ianm8/uDSR/src/README.md

## Prerequisites
This is an Arduino project for the Pi Pico 2. You will need the Pico Arduino core by Earle Philhower available here:

https://github.com/earlephilhower/arduino-pico

## Libraries
 * Install the Tiny4kOLED library: https://github.com/datacute/Tiny4kOLED
 
## Build
 * Seeed XIAO RP2350
 * CPU Speed: 250Mhz
 * Optimize: -O3
 * USB Stack: No USB
 * Flash Size: 2MB (no FS)

## Some history
 * 0.1.250 start with uDST, uPDCR, and iqSDR40
 * 0.2.250 firmware update from menu
 * 0.3.250 smeter fixes
 * 0.4.250 set smeter by mode
 * 0.5.250 dithered waterfall
 * 0.6.250 waterfall speed
 * 0.7.250 improved noise blanker
 * 1.0.250 release
 * 1.1.250 limiter (audio blanker)
