ianm8/uDSR/PCB/README.md

# PCB Top View

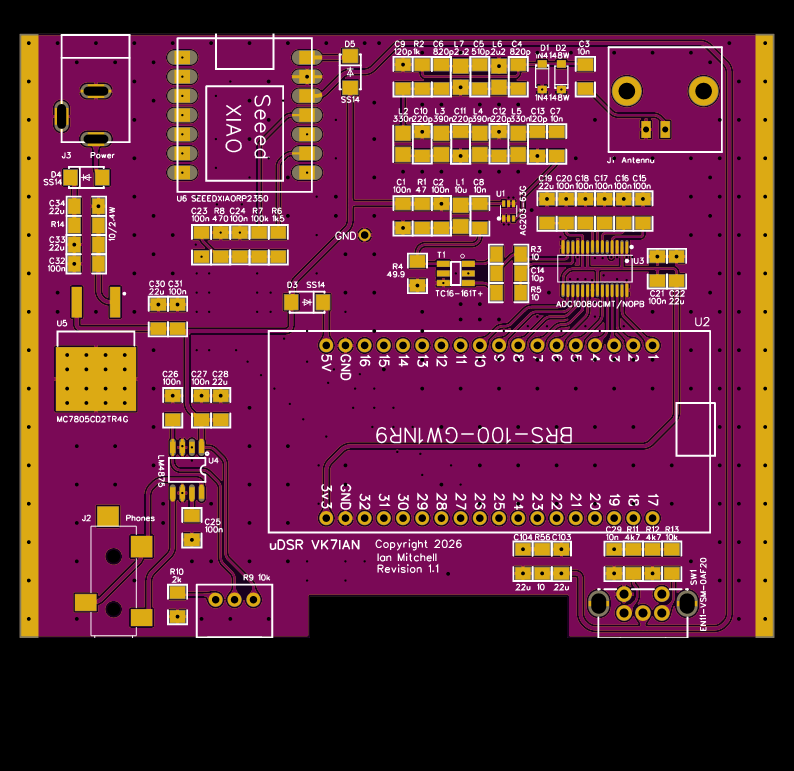
[picture p6: PCB/uDSR-Top-View_2026-10-17.png]
uDSR PCB Top


# PCB Bottom View

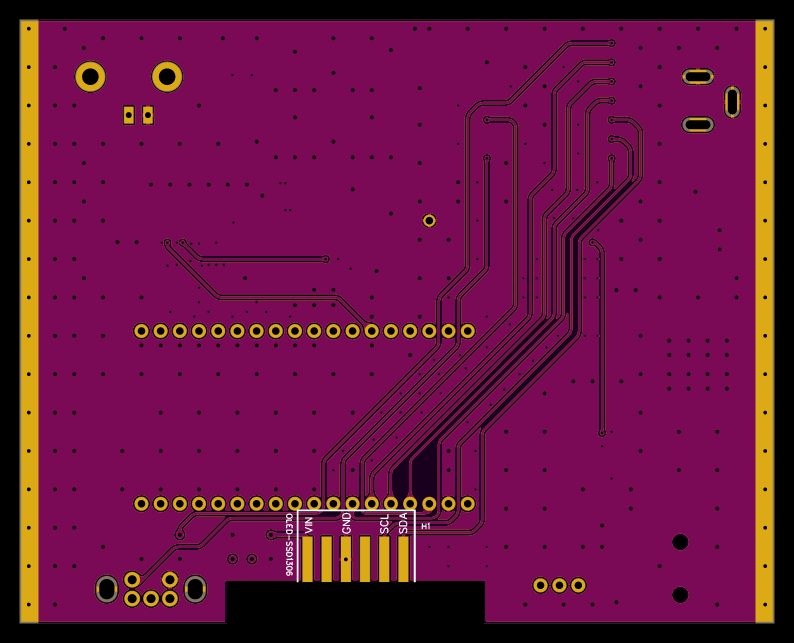
[picture p7: PCB/uDSR-Bottom-View_2026-10-17.png]
uDSR PCB Bottom
