ianm8/uDSR/docs/uDSR_CIC_response.png

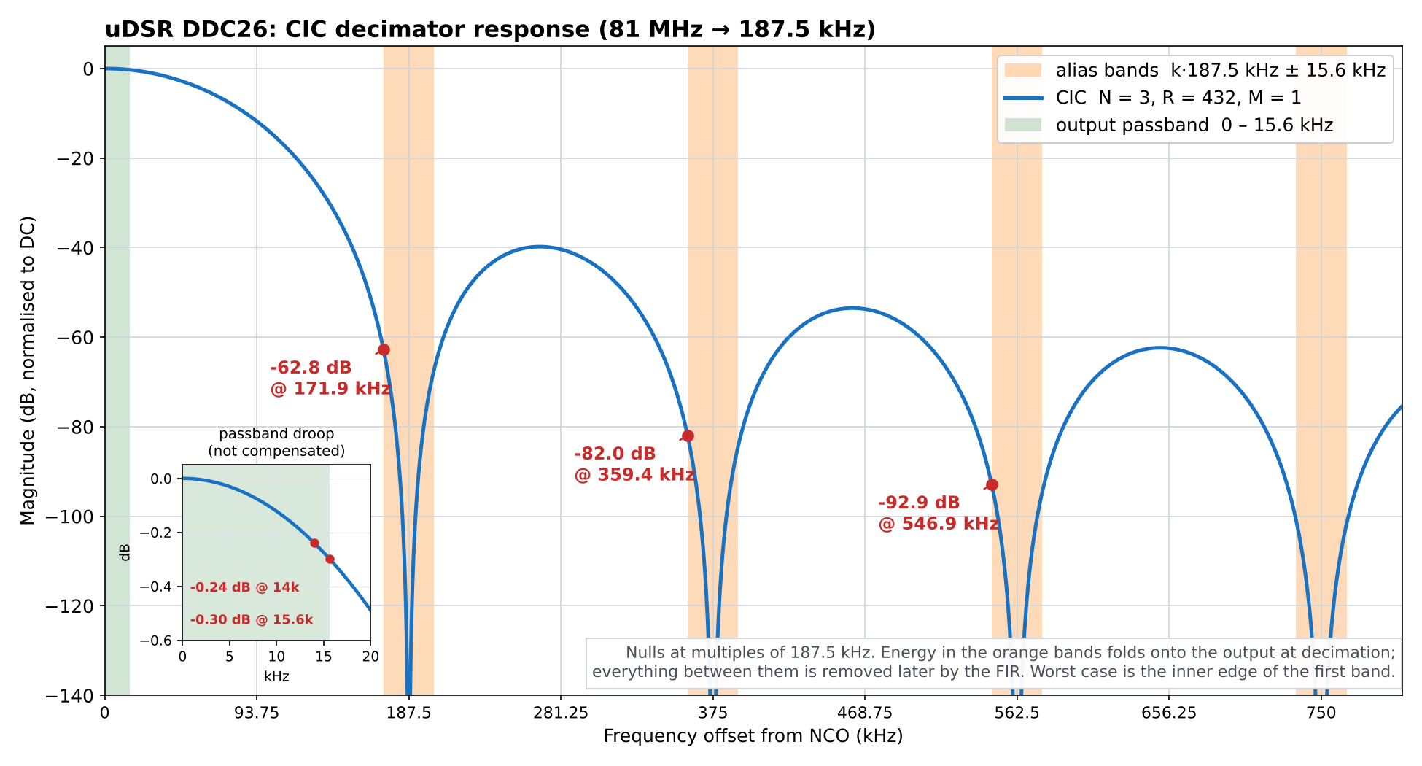
docs/uDSR_CIC_response.png
