ianm8/uDSR/docs/uDSR_FIR_response.png

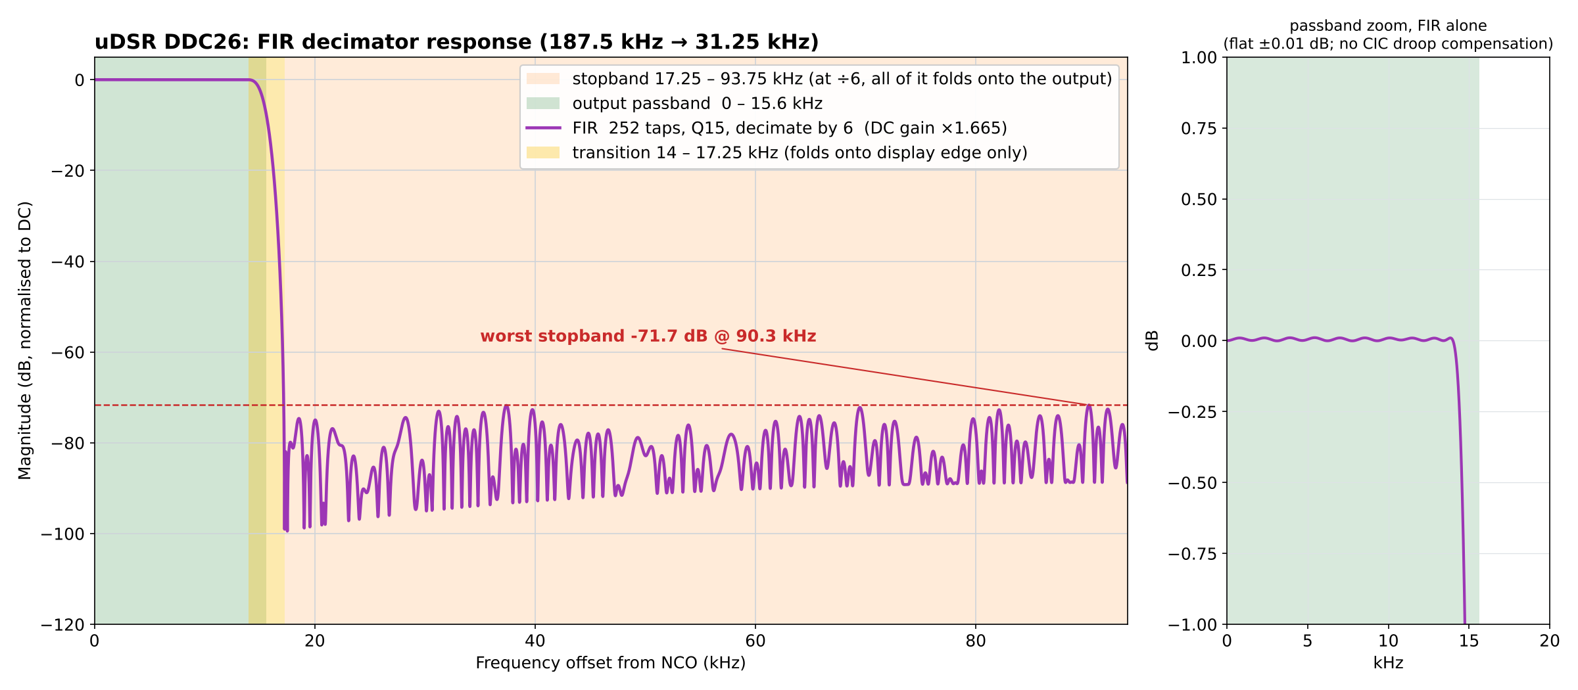
docs/uDSR_FIR_response.png
