ianm8/uDSR/BOM/BOM_uDSR_2026-10-26.csv

ID | Name | Designator | Footprint | Quantity | Manufacturer Part | Manufacturer | Supplier | Supplier Part
1 | 100n | C1,C2,C15,C16,C17,C18,C20,C21,C23,C24,C25,C26,C27,C31,C32 | 1206 | 15
2 | 10n | C3,C7,C8,C29 | 1206 | 4
3 | 820p | C4,C6 | 1206 | 2
4 | 510p | C5 | 1206 | 1
5 | 120p | C9,C13 | 1206 | 2
6 | 220p | C10,C11,C12 | 1206 | 3
7 | 10p | C14 | 1206 | 1
8 | 22u | C19,C22,C28,C30,C33,C34,C103,C104 | 1206 | 8
9 | 1N4148W | D1,D2 | SOD-123_L2.8-W1.8-LS3.7-RD | 2 | 1N4148W-7-F | DIODES |  | C83528
10 | SS14 | D3,D4,D5 | SMA_L4.4-W2.8-LS5.4-RD | 3 | SS14 | MDD | Mouser
11 | OLED-SSD1306 | H1 | LCD4440SM | 1 | 4440 | Adafruit | Mouser | 485-4440
12 | Antenna | J1 | BNC_PCB | 1 |  |  | Mouser | 5227161
13 | Phones | J2 | CUI_SJ-3524-SMT | 1 |  |  |  | SJ-3524-SMT
14 | Power | J3 | DC-072-165A | 1 | PJ-002AH |  |  | PJ-002AH
15 | 10u | L1 | 120608 | 1 |  |  |  | 1206F-100K-01
16 | 330n | L2,L5 | 120608 | 2
17 | 390n | L3,L4 | 120608 | 2
18 | 2u2 | L6,L7 | 120608 | 2
19 | 47 | R1 | 1206 | 1
20 | 1k | R2 | 1206 | 1
21 | 10 | R3,R5,R56 | 1206 | 3
22 | 49.9 | R4 | 1206 | 1
23 | 1k5 | R6 | 1206 | 1
24 | 100k | R7 | 1206 | 1
25 | 470 | R8 | 1206 | 1
26 | 10k | R9 | BOURNS_PTD901_1GANG | 1 | PTD901-1015F-B103 | Bourns | Mouser | PTD901-1015F-B103
27 | 2k | R10 | 1206 | 1
28 | 4k7 | R11,R12 | 1206 | 2
29 | 10k | R13 | 1206 | 1
30 | 10/2.4W | R14 | 1206 | 1 |  |  |  | 352210RJT
31 | EN11-VSM-0AF20 | SW1 | SW-EN11-VSM-0AF20 | 1 | EN11-VSM0AF20 or EN11-VSM1AF20 |  | Digikey | 987-1191-ND
32 | TC16-161T+ | T1 | AT244-1A | 1 | TC16-161T+ | MiniCircuits | Mouser | 139-TC16-161T
33 | AG203-63G | U1 | SOT-363_L2.0-W1.3-P0.65-LS2.1-BL | 1 | AG203-63G | Qorvo
34 | BRS-100-GW1NR9 | U2 | BRS-100-GW1NR9 | 1 |  |  | Brisbane Silicon | BRS-100-GW1NR9
35 | ADC10080CIMT/NOPB | U3 | TSSOP-28_L9.7-W4.4-P0.65-LS6.4-BL | 1 | ADC10080CIMT/NOPB | TI
36 | LM4875 | U4 | SOIC-8 | 1 | LM4875MX/NOPB | TI
37 | MC7805CD2TR4G | U5 | TO-263-2_L10.0-W9.1-P5.08-LS15.2-TL | 1 | MC7805CD2TR4G | onsemi | Mouser | 863-MC7805CD2TR4G
38 | SEEEDXIAORP2350 | U6 | SEEED_XIAO_IM | 1 | 102010550 | Seeedstudio |  | 102010550
39 | Case |  | 1455L802BK | 1 | 1455L802BK | Hammond | Mouser | 546-1455L802BK
