ianm8/uDSR/build/README.md

# A sequence of photos during the build process

### Start with the ADC10080:

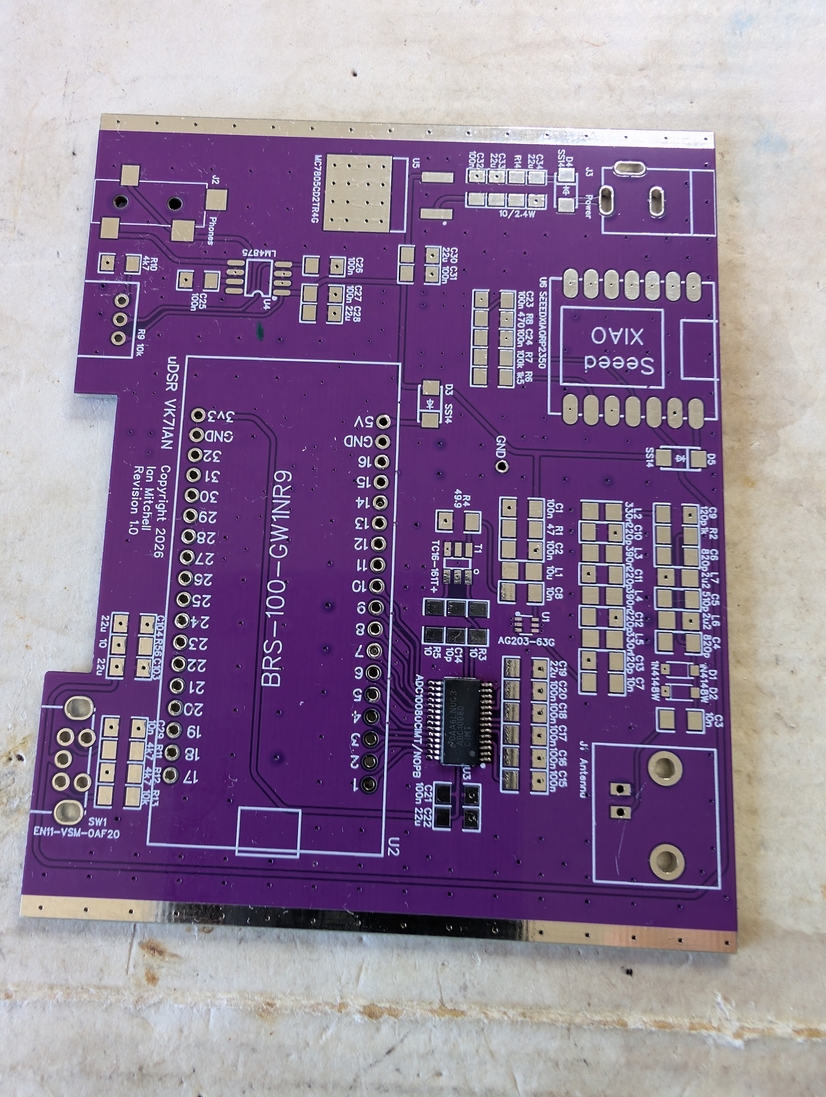
[picture p10: build/PXL_20261014_010341865.jpg]
uDSR Build


### Power supply passive components:

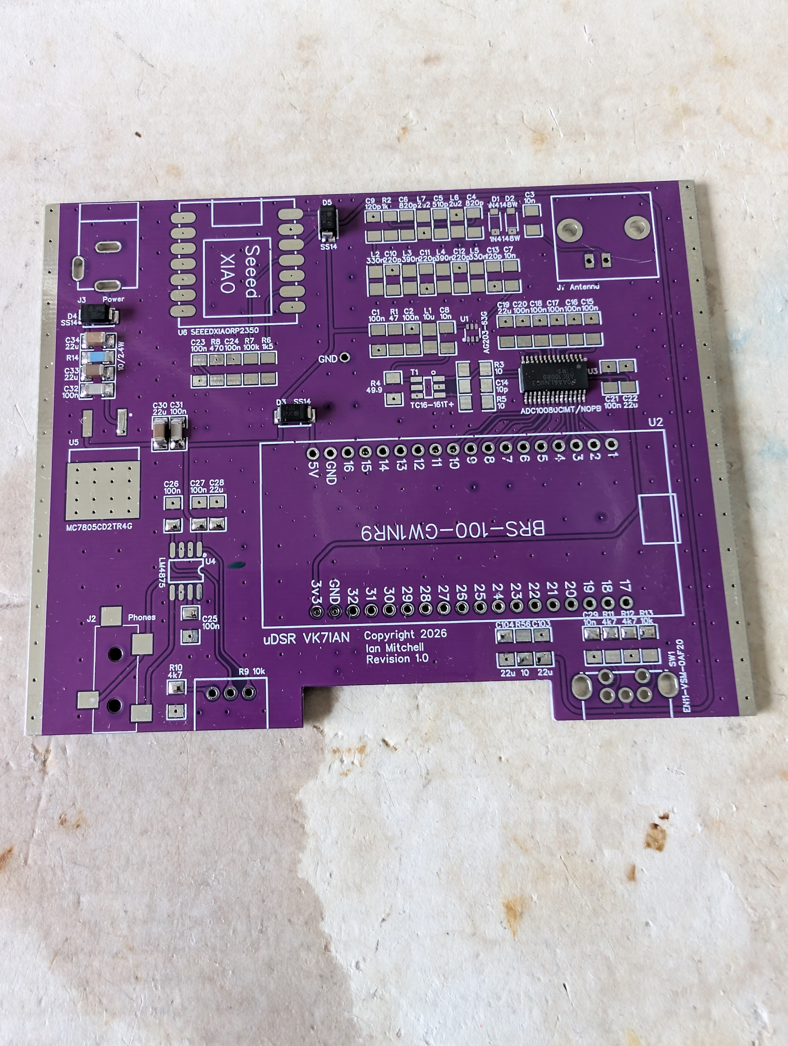
[picture p11: build/PXL_20261014_030042416.jpg]
uDSR Build


### 5V regulator and power connector for testing correct voltages:

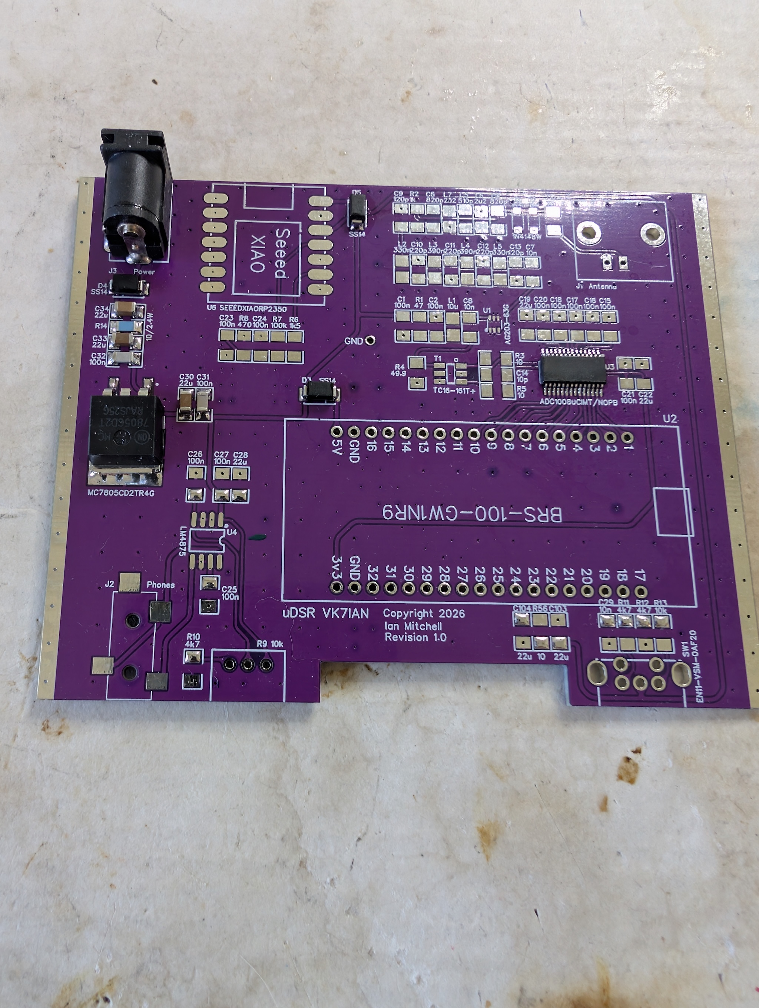
[picture p12: build/PXL_20261014_034947521.jpg]
uDSR Build


### Band-pass filter without the 1k bypass resisor:

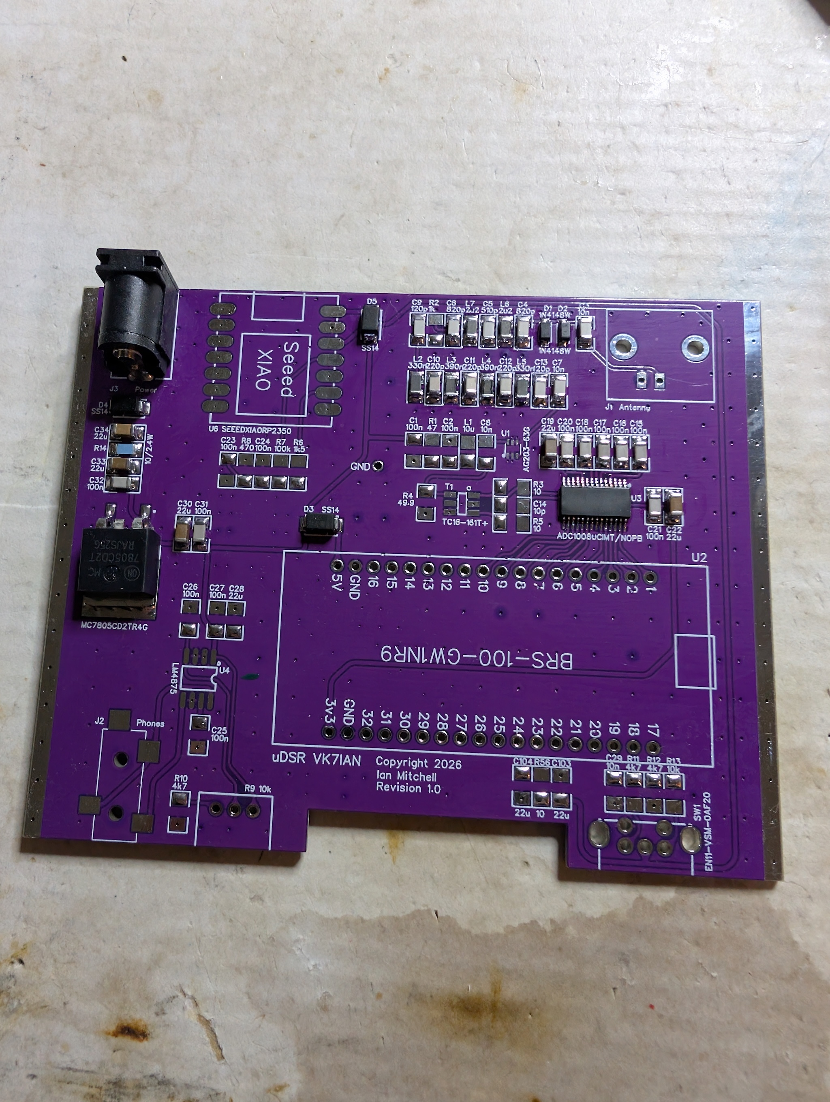
[picture p13: build/PXL_20261014_092210083.jpg]
uDSR Build


### BNC installed and testing the frequency response:

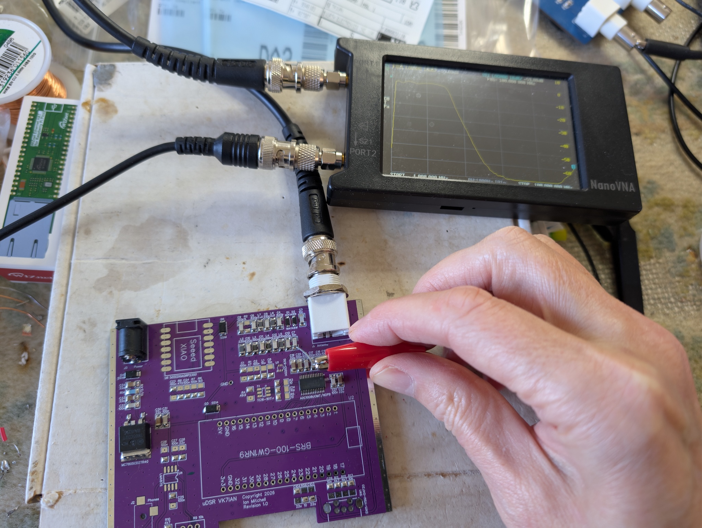
[picture p14: build/PXL_20261015_022853863.jpg]
uDSR Build


### Low-pass cutoff:

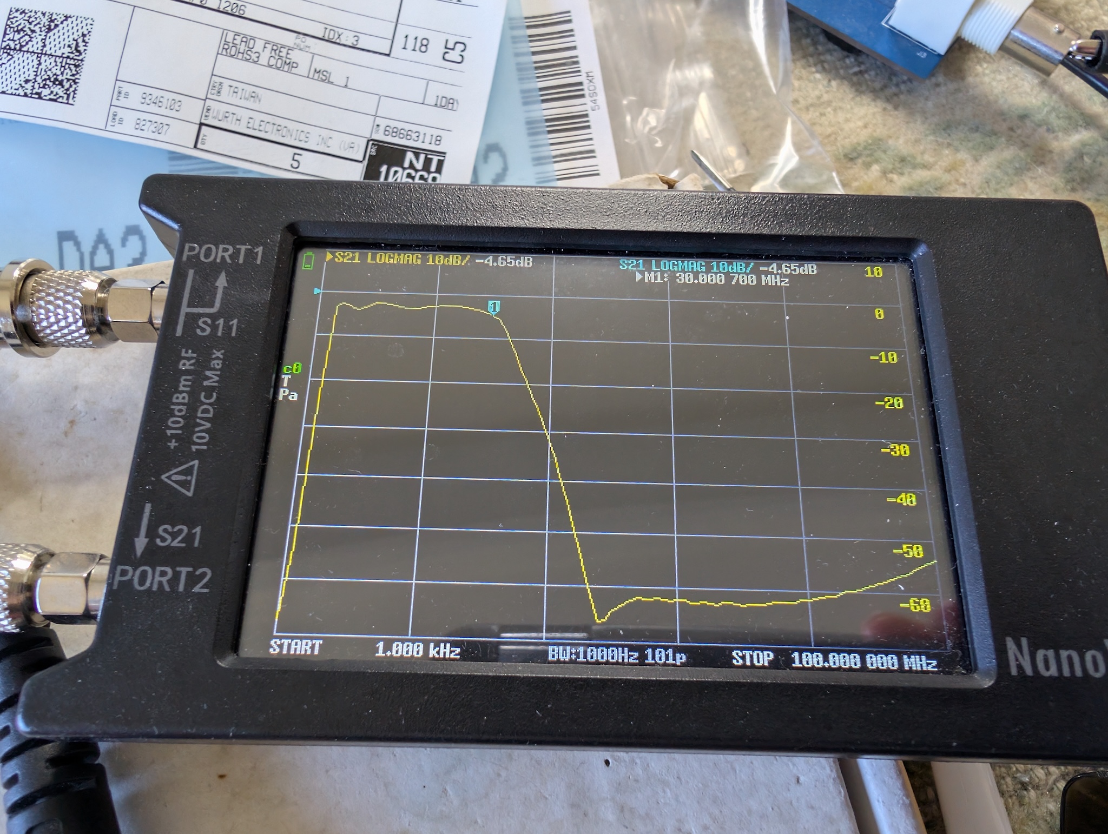
[picture p15: build/PXL_20261015_023100587.jpg]
uDSR Build


### High-pass cutoff:

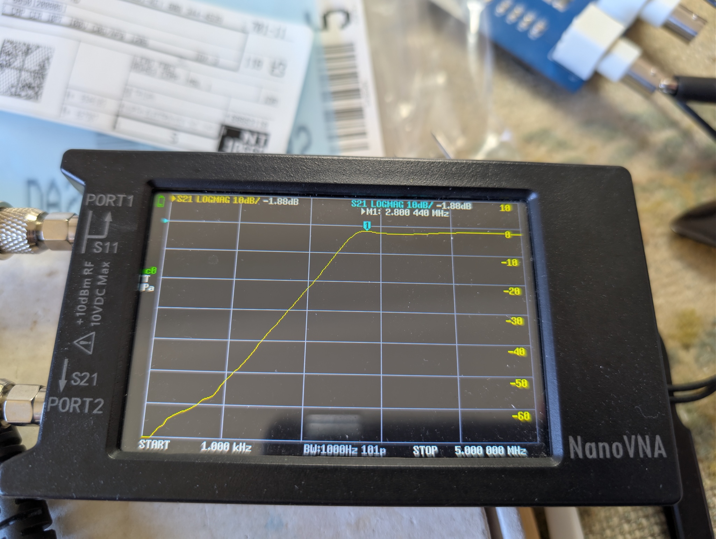
[picture p16: build/PXL_20261015_023230098.jpg]
uDSR Build


### High-pass response before the 1k resistor is added:

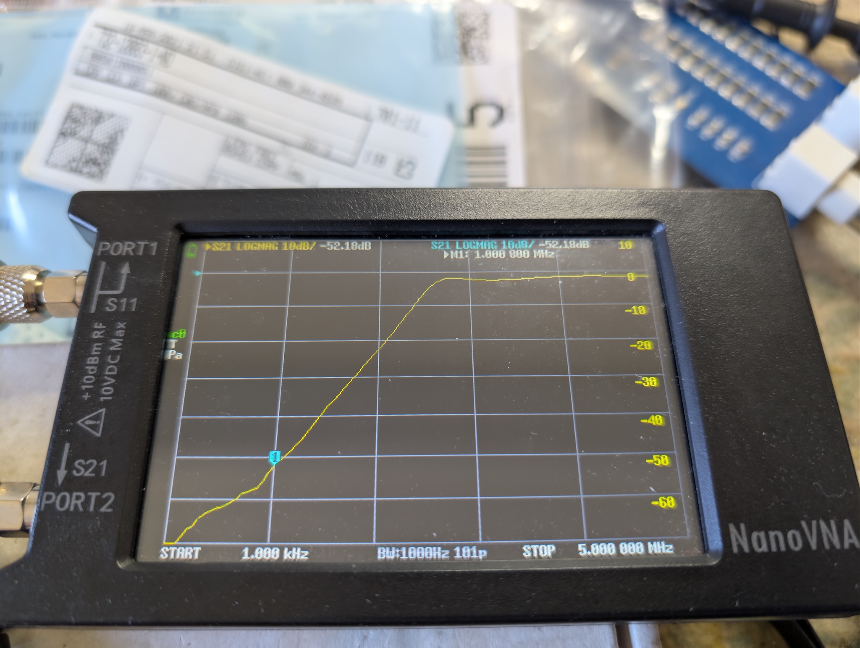
[picture p17: build/PXL_20261015_023336070.jpg]
uDSR Build


### High-pass response with 1k resistor installed:

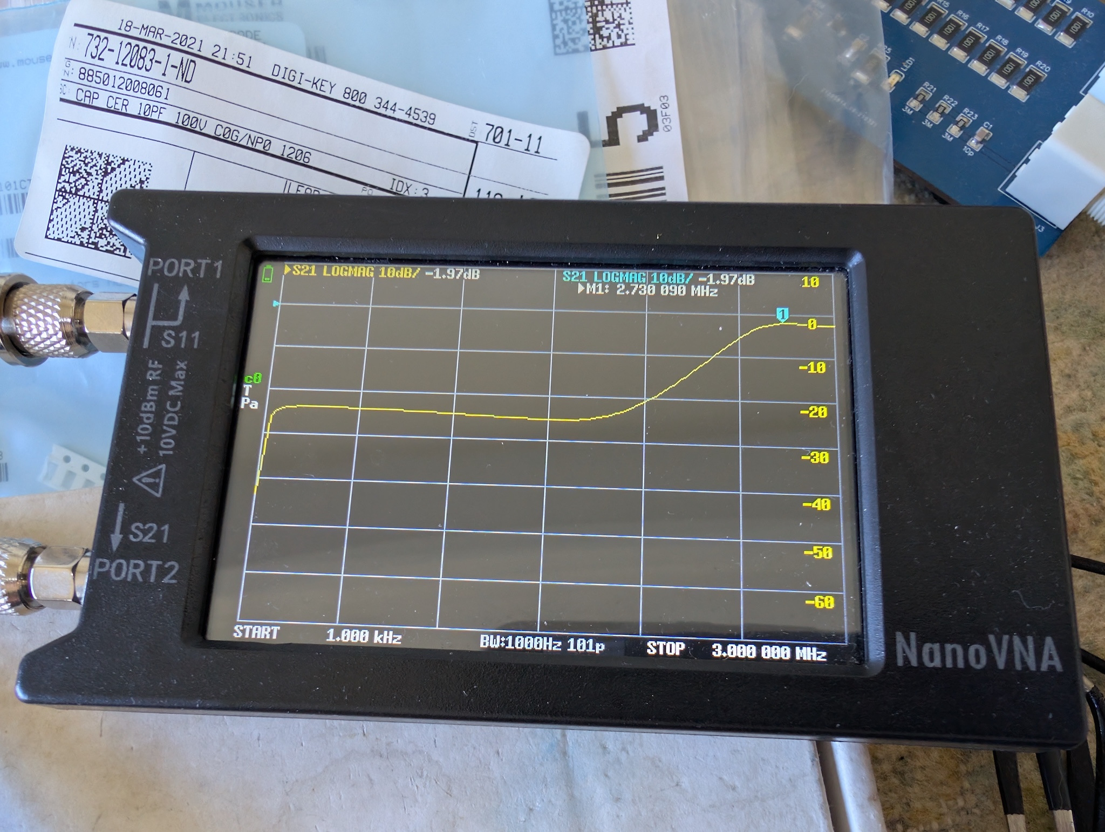
[picture p18: build/PXL_20261015_024127553.jpg]
uDSR Build


### Low frequency response attenuation:

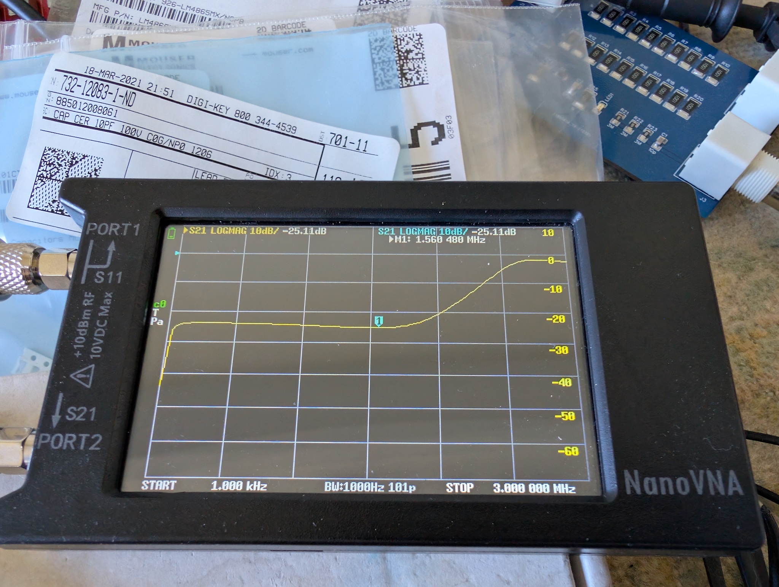
[picture p19: build/PXL_20261015_024207039.jpg]
uDSR Build


### Response up to 10 MHz:

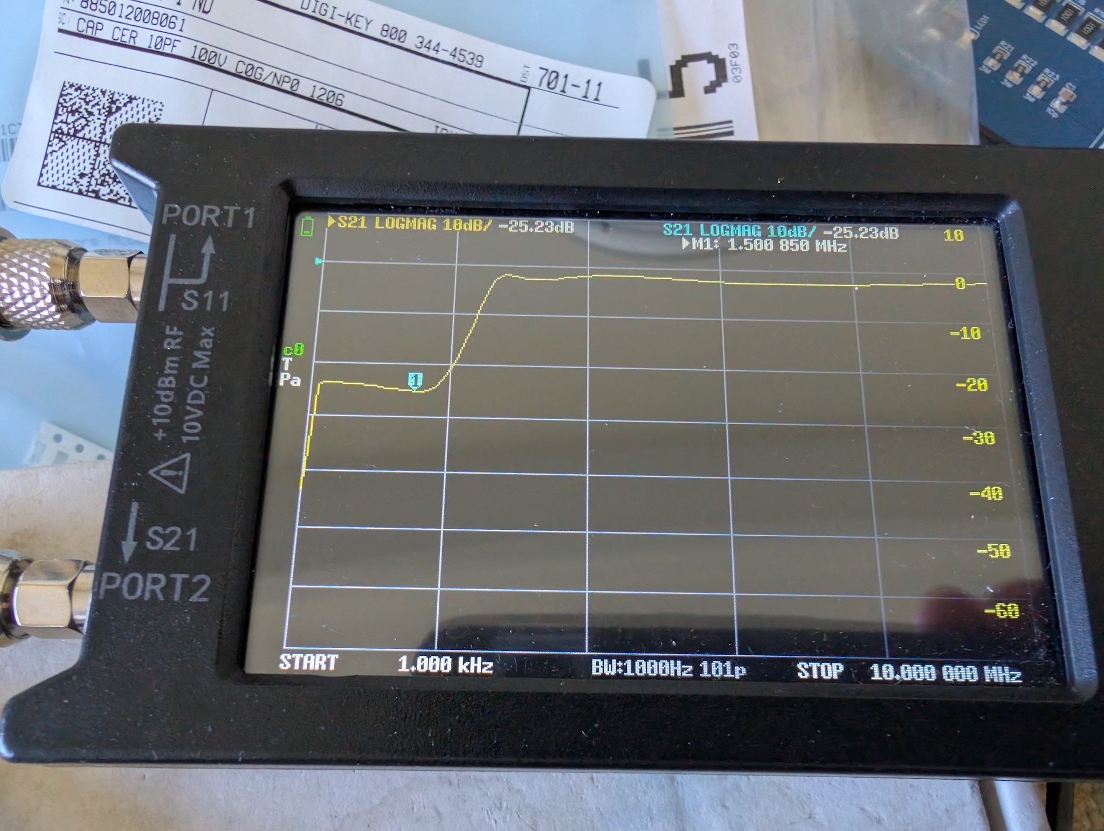
[picture p20: build/PXL_20261015_024229046.jpg]
uDSR Build


### Complete filter response:

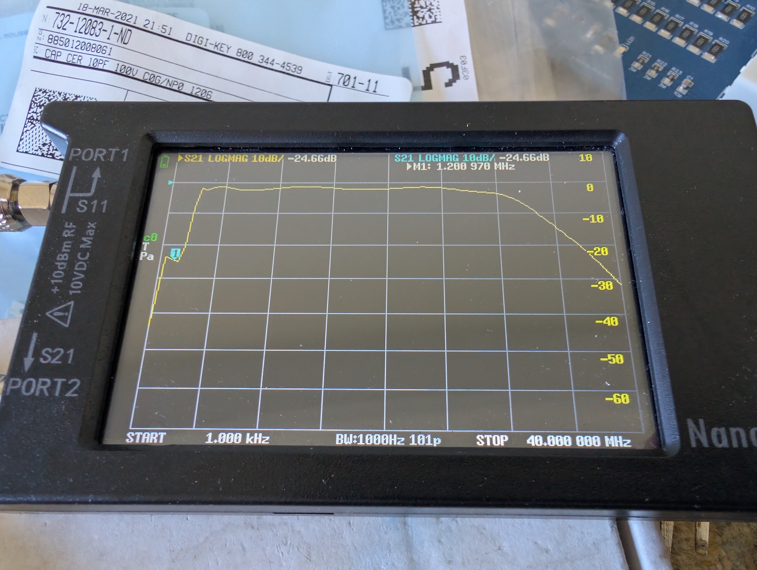
[picture p21: build/PXL_20261015_024305090.jpg]
uDSR Build


### MMIC and transformer installed:

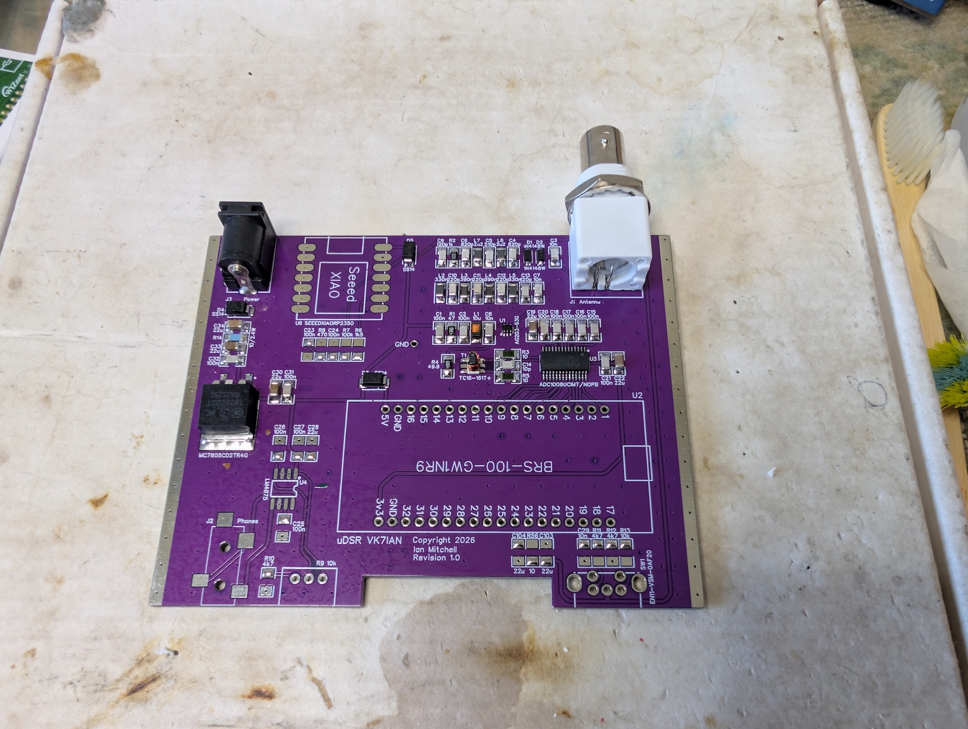
[picture p22: build/PXL_20261015_032219161.jpg]
uDSR Build


### Rotary and display passives:

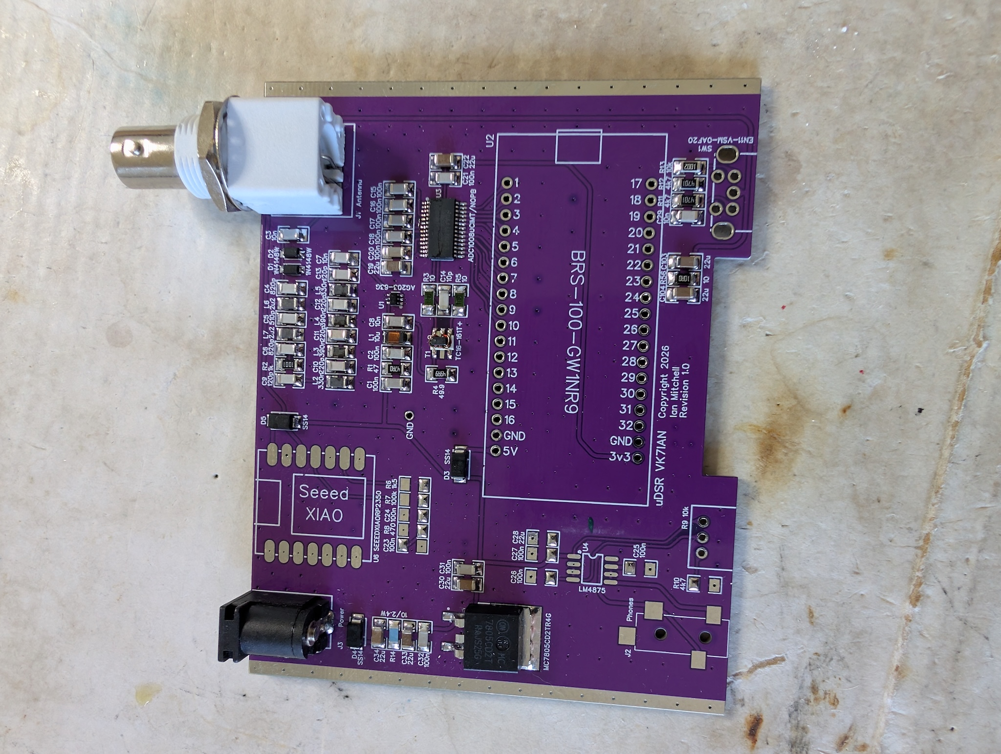
[picture p23: build/PXL_20261015_044840927.jpg]
uDSR Build


### Remaining passives:

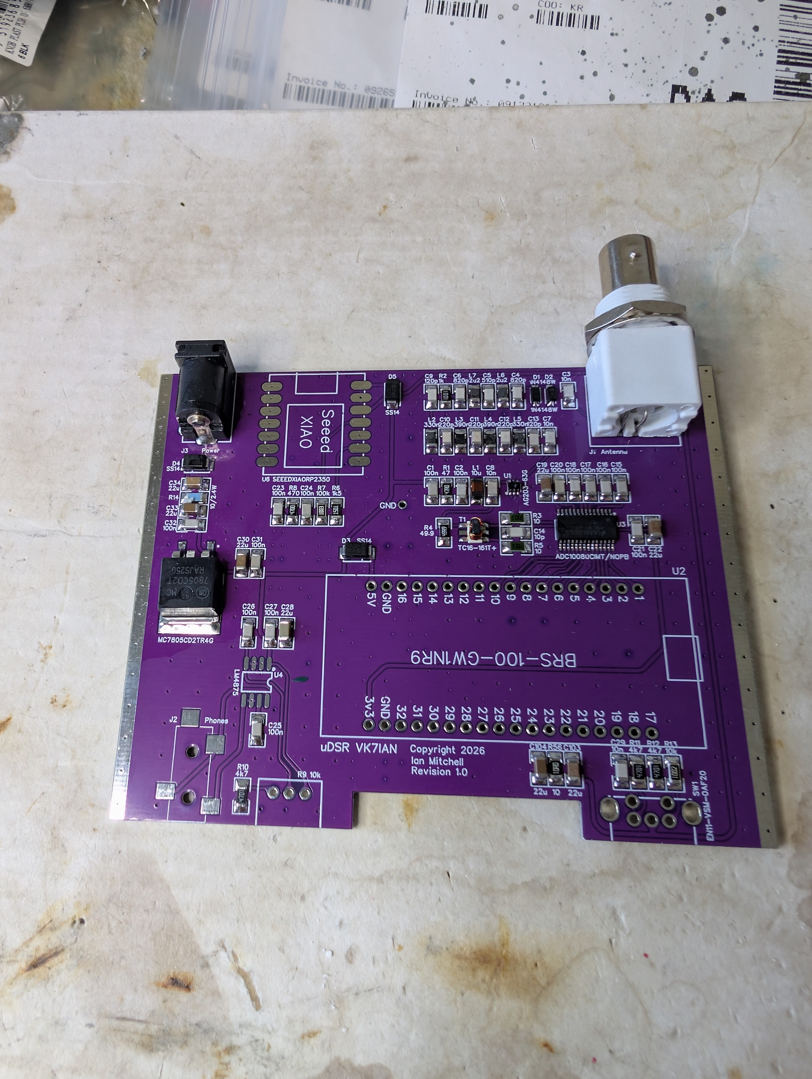
[picture p24: build/PXL_20261015_055033805.jpg]
uDSR Build


### RP2350 and OLED installed for testing:

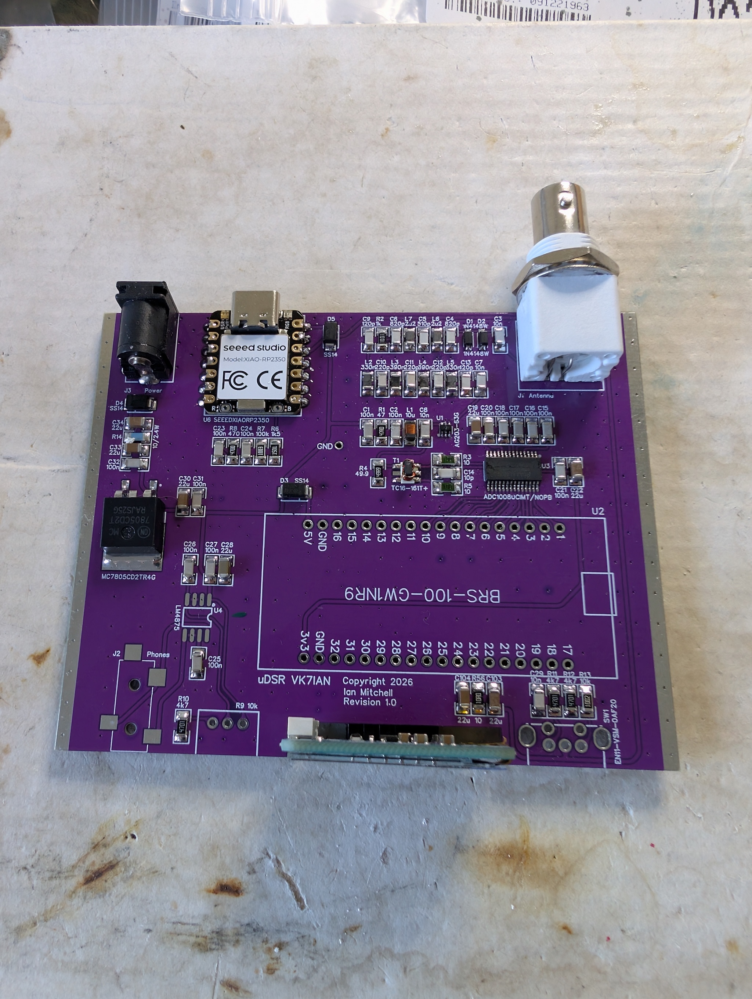
[picture p25: build/PXL_20261015_064001643.jpg]
uDSR Build


### Rotary encoder and FPGA board installed for testing:

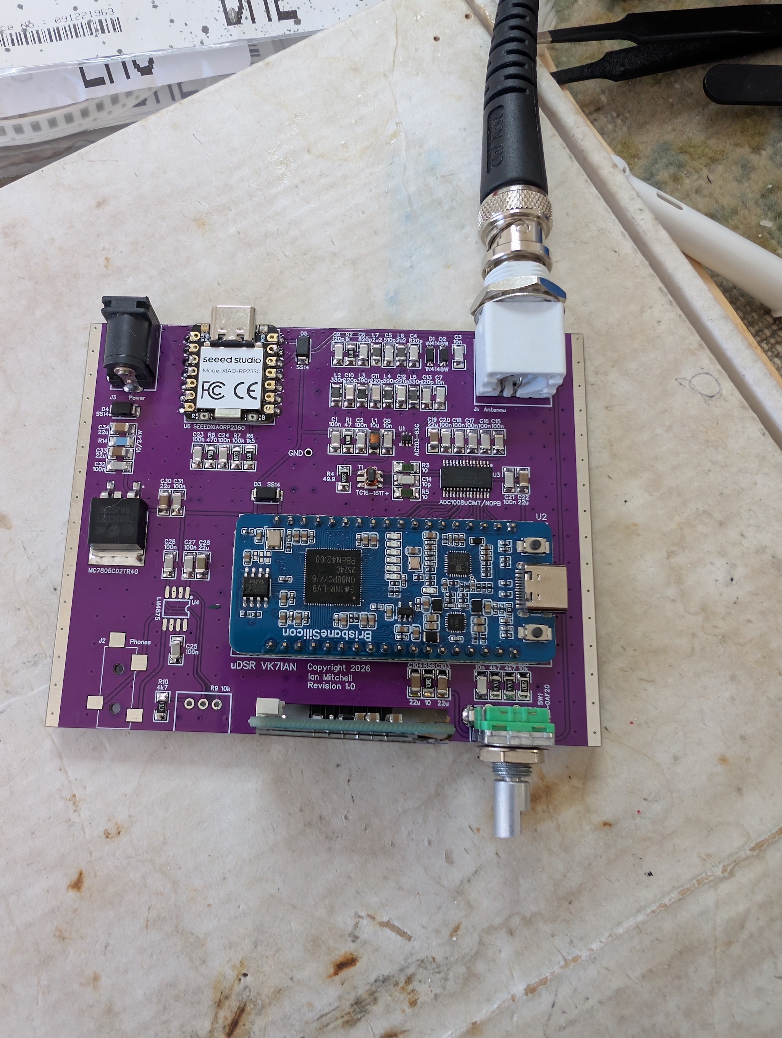
[picture p26: build/PXL_20261015_225128917.jpg]
uDSR Build


### Board complete:

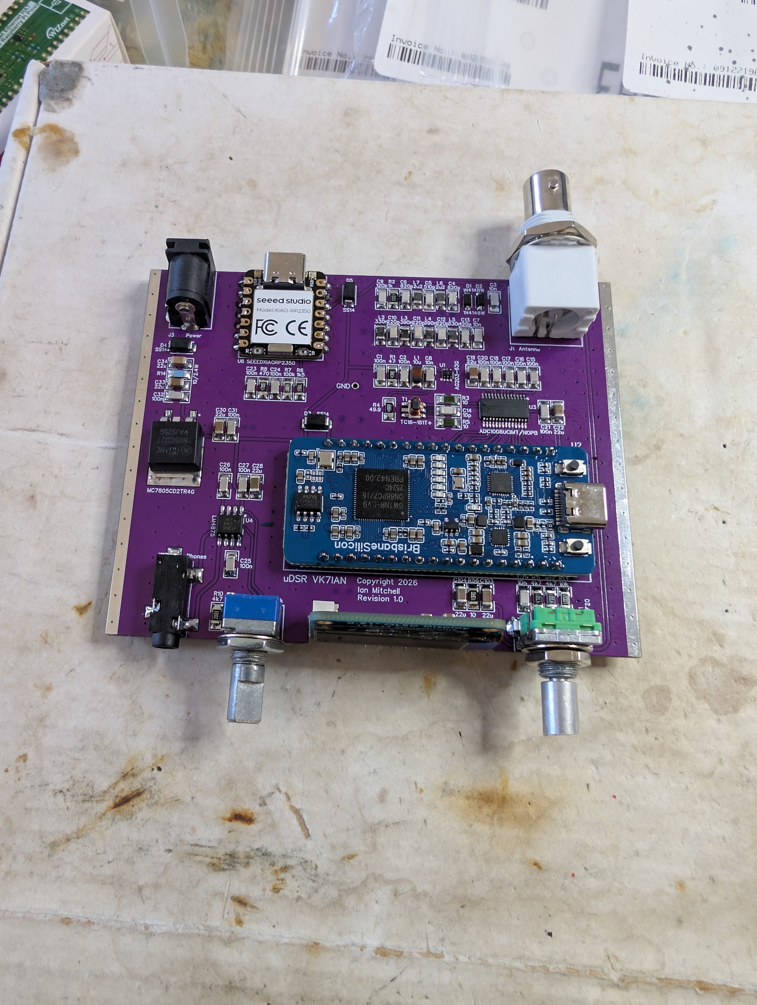
[picture p27: build/PXL_20261016_002111216.jpg]
uDSR Build
