ianm8/uDSR/docs/Schematic_uDSR_2026-10-16.pdf

## Revision 1.1 * change R10 to 2k

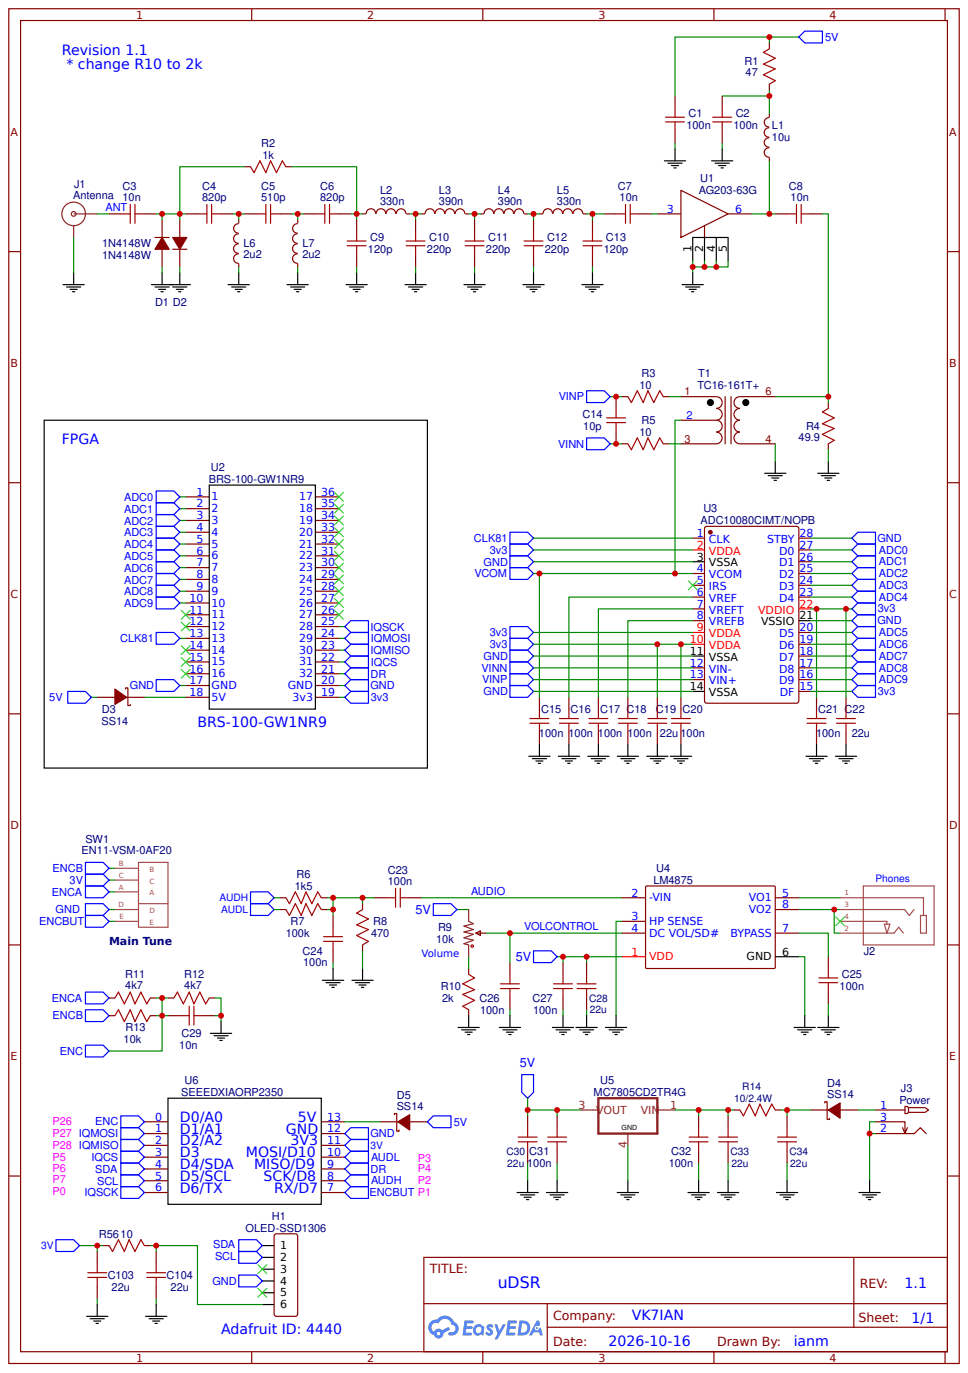
[picture p28: page 1]

BYPASS 7 DC VOL/SD# 4 HP SENSE 3
