ianm8/uDSR/src/spectrum.h

#ifndef SPECTRUM_H
#define SPECTRUM_H

#define FFT_N 1024u

namespace spectrum
{
  static const int16_t __not_in_flash("fast_access_sram") window_hanning_1024[] =
  {
    0,     0,     1,     2,     4,     7,     11,    15,    19,    25,    30,
    37,    44,    52,    60,    69,    79,    89,    100,   111,   123,   136,
    149,   163,   177,   192,   208,   224,   241,   259,   277,   296,   315,
    335,   355,   377,   398,   421,   444,   467,   491,   516,   542,   568,
    594,   621,   649,   677,   706,   736,   766,   797,   828,   860,   892,
    925,   959,   993,   1028,  1063,  1099,  1136,  1173,  1211,  1249,  1288,
    1327,  1367,  1408,  1449,  1491,  1533,  1576,  1619,  1663,  1707,  1752,
    1798,  1844,  1891,  1938,  1986,  2034,  2083,  2132,  2182,  2232,  2283,
    2335,  2387,  2439,  2493,  2546,  2600,  2655,  2710,  2766,  2822,  2879,
    2936,  2994,  3052,  3111,  3170,  3230,  3290,  3351,  3412,  3474,  3536,
    3599,  3662,  3725,  3789,  3854,  3919,  3985,  4051,  4117,  4184,  4252,
    4319,  4388,  4456,  4526,  4595,  4665,  4736,  4807,  4878,  4950,  5023,
    5095,  5168,  5242,  5316,  5390,  5465,  5540,  5616,  5692,  5769,  5845,
    5923,  6000,  6078,  6157,  6236,  6315,  6394,  6474,  6555,  6635,  6716,
    6798,  6880,  6962,  7044,  7127,  7210,  7294,  7378,  7462,  7547,  7631,
    7717,  7802,  7888,  7974,  8061,  8148,  8235,  8322,  8410,  8498,  8586,
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
      0x0fu,
      0x0fu,
      0x10u,
      0x10u,
      0x10u,
      0x10u,
      0x10u,
      0x11u,
      0x11u,
      0x11u,
      0x11u,
      0x11u,
      0x12u,
      0x12u,
      0x12u,
      0x12u,
      0x12u,
      0x12u,
      0x12u,
      0x13u,
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
    };
    return logtab32[l];
  }

  // In-place forward FFT. re[] and im[] must each hold FFT_N floats and must
  // not overlap.
  static void __not_in_flash_func(fft1024)(float * __restrict re, float * __restrict im)
  {
    // ---- bit-reversal permutation) ----
    uint32_t j = 0;
    for (uint32_t i = 0; i < FFT_N - 1; i++)
    {
      if (i < j)
      {
        const float tr = re[i]; re[i] = re[j]; re[j] = tr;
        const float ti = im[i]; im[i] = im[j]; im[j] = ti;
      }
      uint32_t k = FFT_N >> 1;
      while (k <= j) { j -= k; k >>= 1; }
      j += k;
    }

    // ---- butterflies: 10 stages ----
    for (uint32_t half = 1; half < FFT_N; half <<= 1)
    {
      const uint32_t size = half << 1;
      const uint32_t step = FFT_N / size; // twiddle stride in the table
      for (uint32_t start = 0; start < FFT_N; start += size)
      {
        uint32_t t = 0;
        for (uint32_t m = 0; m < half; m++, t += step)
        {
          const float wr = fft_cos_tab[t];
          const float wi = fft_sin_tab[t];
          const uint32_t a = start + m;
          const uint32_t b = a + half;
          const float xr = re[b] * wr - im[b] * wi;
          const float xi = re[b] * wi + im[b] * wr;
          re[b] = re[a] - xr;   im[b] = im[a] - xi;
          re[a] += xr;          im[a] += xi;
        }
      }
    }
  }

  void __not_in_flash_func(process)(int16_t ii[], int16_t qq[], uint8_t mag[], const int8_t gain)
  {
    static float re[FFT_N] = { 0 };
    static float im[FFT_N] = { 0 };

    // ---- persistent DC estimate ----------------------------------------
    // Leaky integrator: dc_est is the running mean, in ADC counts, updated
    // 1/64th of the way toward each block's mean. 64 blocks at 31250/1024 =
    // 30.5 blocks/s is ~2.1 s, i.e. a ~0.5 Hz corner. Anything tuned further
    // than that off centre is rejected as AC no matter how strong it is.
    static constexpr float    DC_TC     = 1.0f / 64.0f;
    static constexpr float    dev_limit = 1.0f;   // 1 count
    static constexpr float    dc_clamp  = 4.0f;   // largest believable bias
    static constexpr uint32_t DC_REACQ  = 30;     // blocks, ~1 s
    static float    dc1_est = 0.0f;
    static float    dc2_est = 0.0f;
    static float    dc1_sum = 0.0f;
    static float    dc2_sum = 0.0f;
    static uint32_t dc_count = 0;
    static bool     dc_primed = false;

    int32_t dc1 = 0;
    int32_t dc2 = 0;
    for (uint32_t i = 0; i < FFT_N; i++)
    {
      dc1 += ii[i];
      dc2 += qq[i];
    }
    const float mean1 = (float)dc1 * (1.0f / (float)FFT_N);
    const float mean2 = (float)dc2 * (1.0f / (float)FFT_N);
    if (!dc_primed)
    {
      dc1_est = mean1;
      dc2_est = mean2;
      dc_primed = true;
    }
    else
    {
      // normal tracking: gate on deviation from the estimate
      const float dev1 = mean1 - dc1_est;
      const float dev2 = mean2 - dc2_est;
      if (fabsf(dev1) <= dev_limit && fabsf(dev2) <= dev_limit)
      {
        dc1_est += dev1 * DC_TC;
        dc2_est += dev2 * DC_TC;
      }

      // re-acquire: if the centre has been quiet (mean small enough to be
      // bias, not a carrier) for DC_REACQ blocks in a row and the average
      // disagrees with the estimate, the estimate is stale. Replace it.
      if (fabsf(mean1) <= dc_clamp && fabsf(mean2) <= dc_clamp)
      {
        dc1_sum += mean1;
        dc2_sum += mean2;
        if (++dc_count >= DC_REACQ)
        {
          const float avg1 = dc1_sum * (1.0f / (float)DC_REACQ);
          const float avg2 = dc2_sum * (1.0f / (float)DC_REACQ);
          if (fabsf(avg1 - dc1_est) > dev_limit || fabsf(avg2 - dc2_est) > dev_limit)
          {
            dc1_est = avg1;
            dc2_est = avg2;
          }
          dc1_sum = 0.0f;
          dc2_sum = 0.0f;
          dc_count = 0;
        }
      }
      else
      {
        dc1_sum = 0.0f;
        dc2_sum = 0.0f;
        dc_count = 0;
      }
    }
    dc1_est = dc1_est >  dc_clamp ?  dc_clamp : (dc1_est < -dc_clamp ? -dc_clamp : dc1_est);
    dc2_est = dc2_est >  dc_clamp ?  dc_clamp : (dc2_est < -dc_clamp ? -dc_clamp : dc2_est);

    // ---- DC removal folded into the window multiply ---------------------
    const float scale = ldexpf(1.0f, gain) / (32768.0f * (float)FFT_N);
    for (uint32_t i = 0; i < FFT_N; i++)
    {
      const float w = (float)window_hanning_1024[i] * scale;
      re[i] = ((float)ii[i] - dc1_est) * w;
      im[i] = ((float)qq[i] - dc2_est) * w;
    }

    // forward, complex FFT
    fft1024(re, im);

    // magnitude, log, and reverse the frequency bins
    // so that they are in order
    for (int32_t i = 0, j = 511; i < 512; i++, j--)
    {
      mag[i] = log32((uint32_t)sqrtf(re[j] * re[j] + im[j] * im[j]));
    }
    for (int32_t i = 512, j = 1023; i < 1024; i++, j--)
    {
      mag[i] = log32((uint32_t)sqrtf(re[j] * re[j] + im[j] * im[j]));
    }
  }
}

#endif
