ianm8/uDSR/(commit log)

2026-10-16 Add initial FPGA and Circuit Details section
2026-10-16 Add initial PCB file with placeholder content
2026-10-16 Create README.md for PCB
    Add initial README for PCB project
2026-10-16 uDSR vs uDST
    [uDST_vs_uDSR_sensitivity.xlsx]
2026-10-16 PCB Complete
2026-10-17 Enhance README with FPGA and circuit details
    Expanded the README with detailed FPGA and circuit information, including RF front end, ADC, microcontroller, audio output, tuning control, and power specifications.
2026-10-17 Update README with additional testing images and sections
    Added images and sections for testing voltages, band-pass filter, and frequency response.
2026-10-17 Update README with additional filter response images
2026-10-17 Add FPGA programming instructions to README
    Added instructions for FPGA programming and device setup.
2026-10-17 Revision 1.1
    Updated README to include top and bottom views of the PCB.
2026-10-24 Revision 1.1
    Gerbers
2026-10-25 Revision 1.1
    [BOM_uDSR_2026-10-26.csv, BOM_uDSR_2026-10-26.xlsx]
2026-10-25 Revision 1.1
    Added detailed specifications for resistors, capacitors, and inductors.
