ianm8/uDSR/PXL_20261016_035806759.jpg

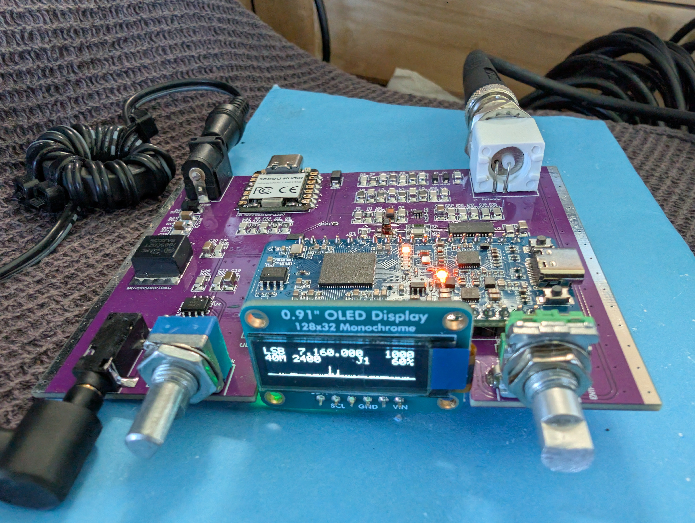
[picture p2: docs/PXL_20261016_035806759.jpg]
PXL_20261016_035806759.jpg
