ianm8/uDSR/PXL_20261016_035903271.jpg

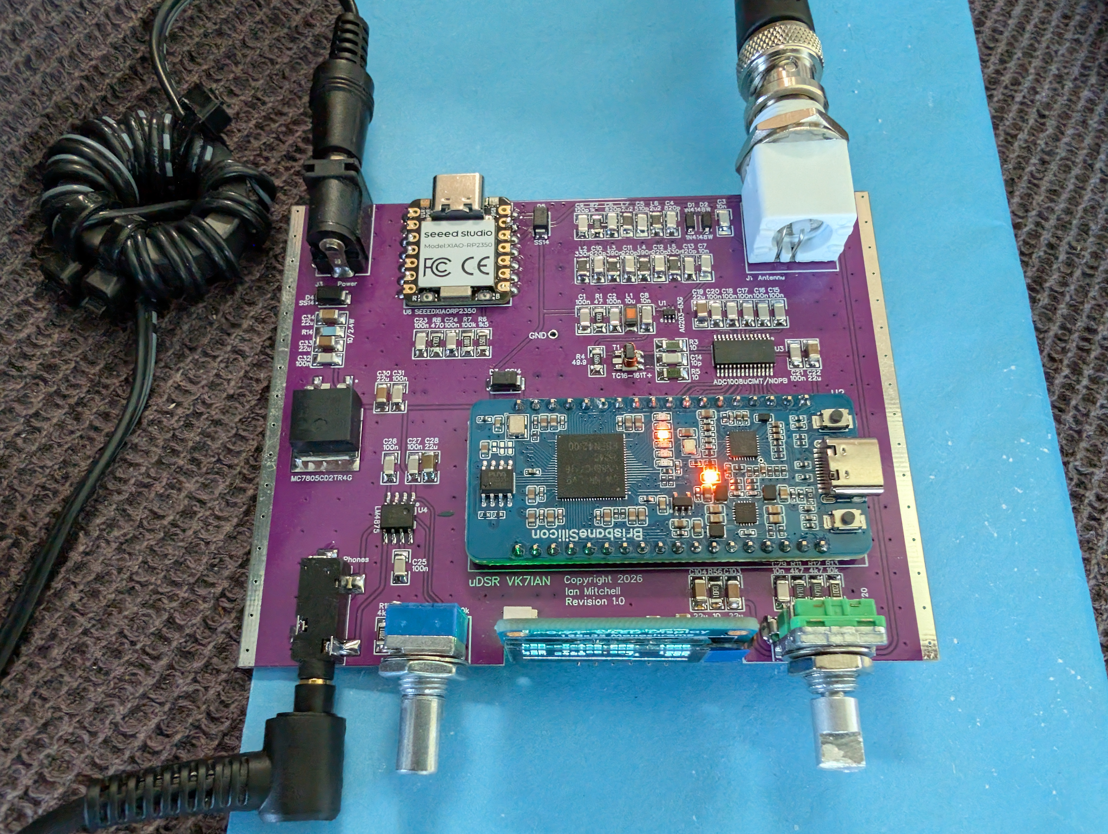
[picture p3: docs/PXL_20261016_035903271.jpg]
PXL_20261016_035903271.jpg
